Thoric16/bakalarka/Architecture_test_measurement/IMG_20260623_165900.jpg

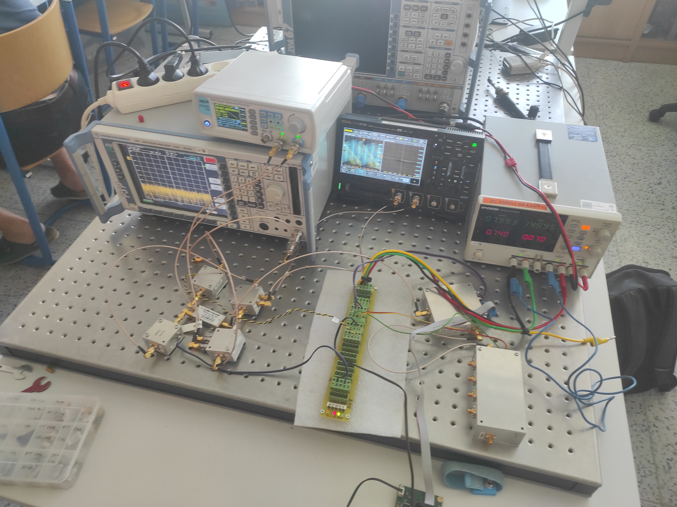
Architecture_test_measurement/IMG_20260623_165900.jpg
