Thoric16/bakalarka/Datasheets/image.png

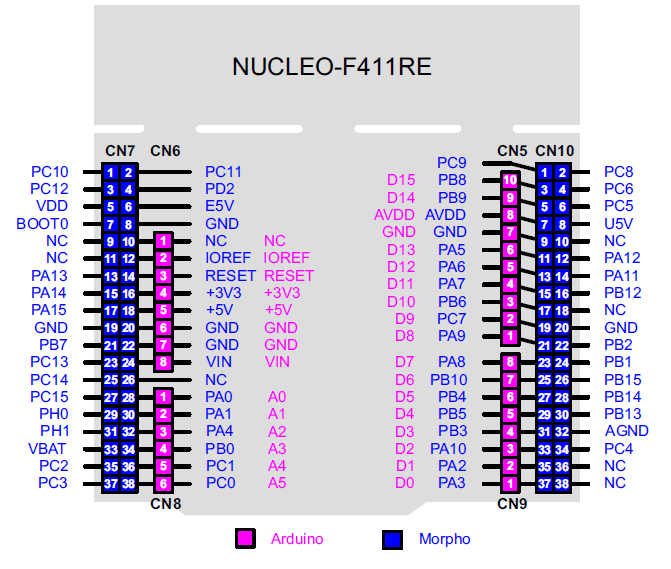
Datasheets/image.png
