Thoric16/bakalarka/preliminary block diagram/diagram_rev1.png

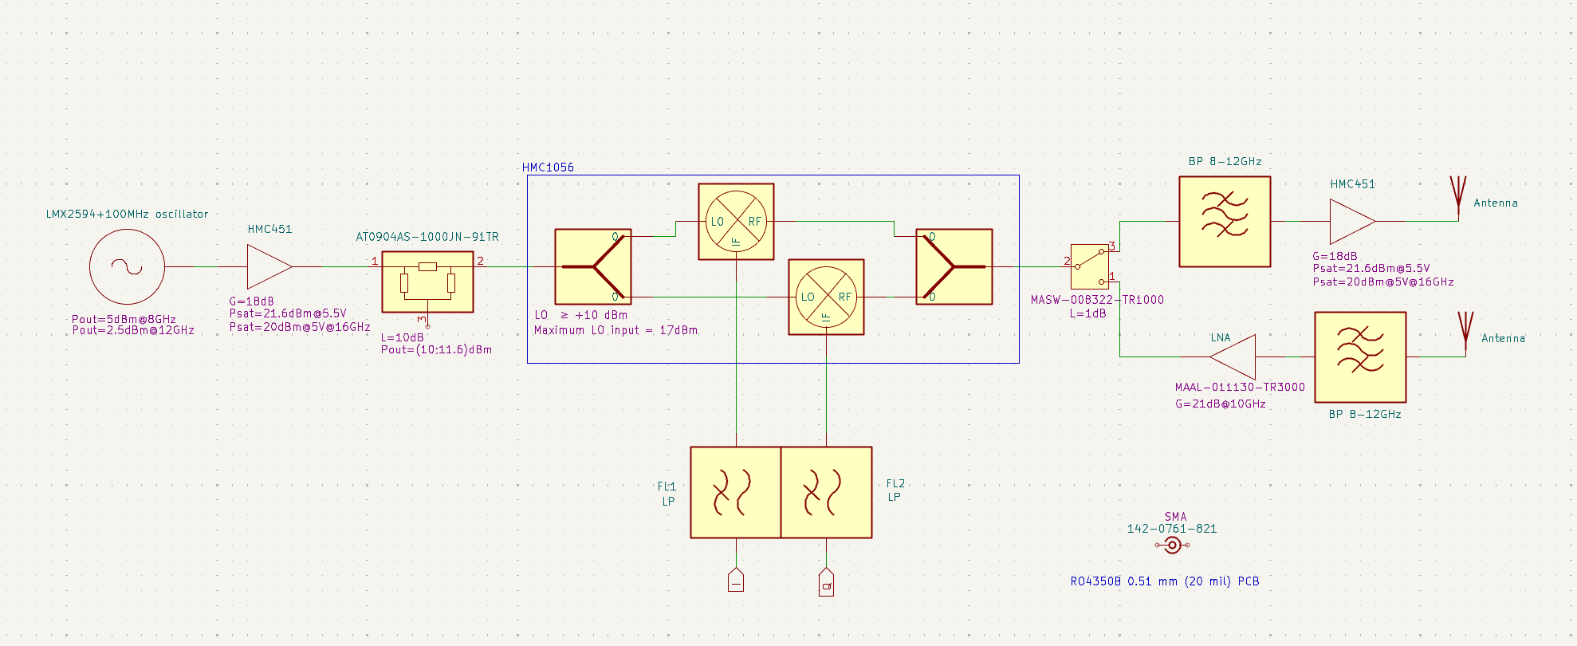
preliminary block diagram/diagram_rev1.png
