Thoric16/bakalarka/STM_QAM_GENERATOR/SHIELD_FW/Communication_protocol/image.png

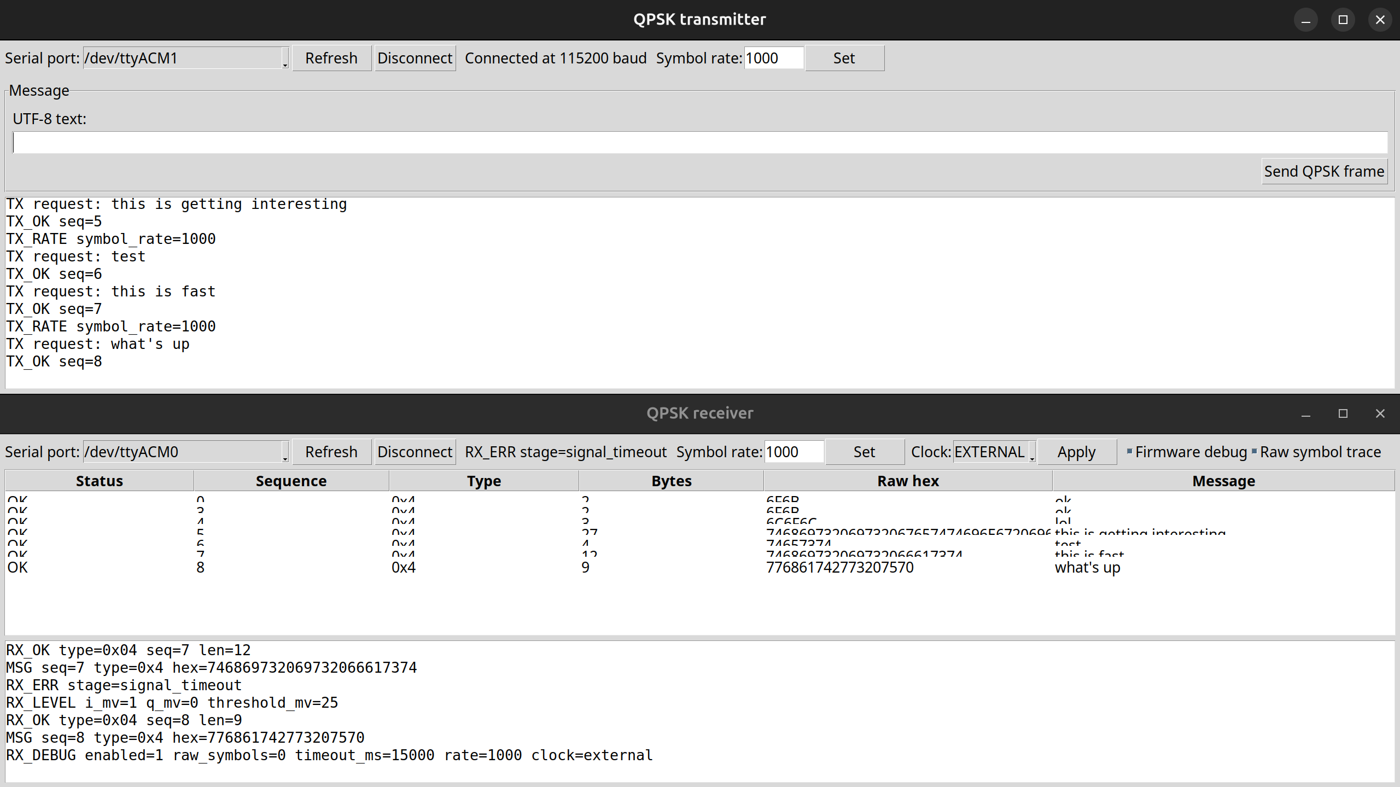
STM_QAM_GENERATOR/SHIELD_FW/Communication_protocol/image.png
