Thoric16/bakalarka/STM_QAM_GENERATOR/STM_SHIELD/image.png

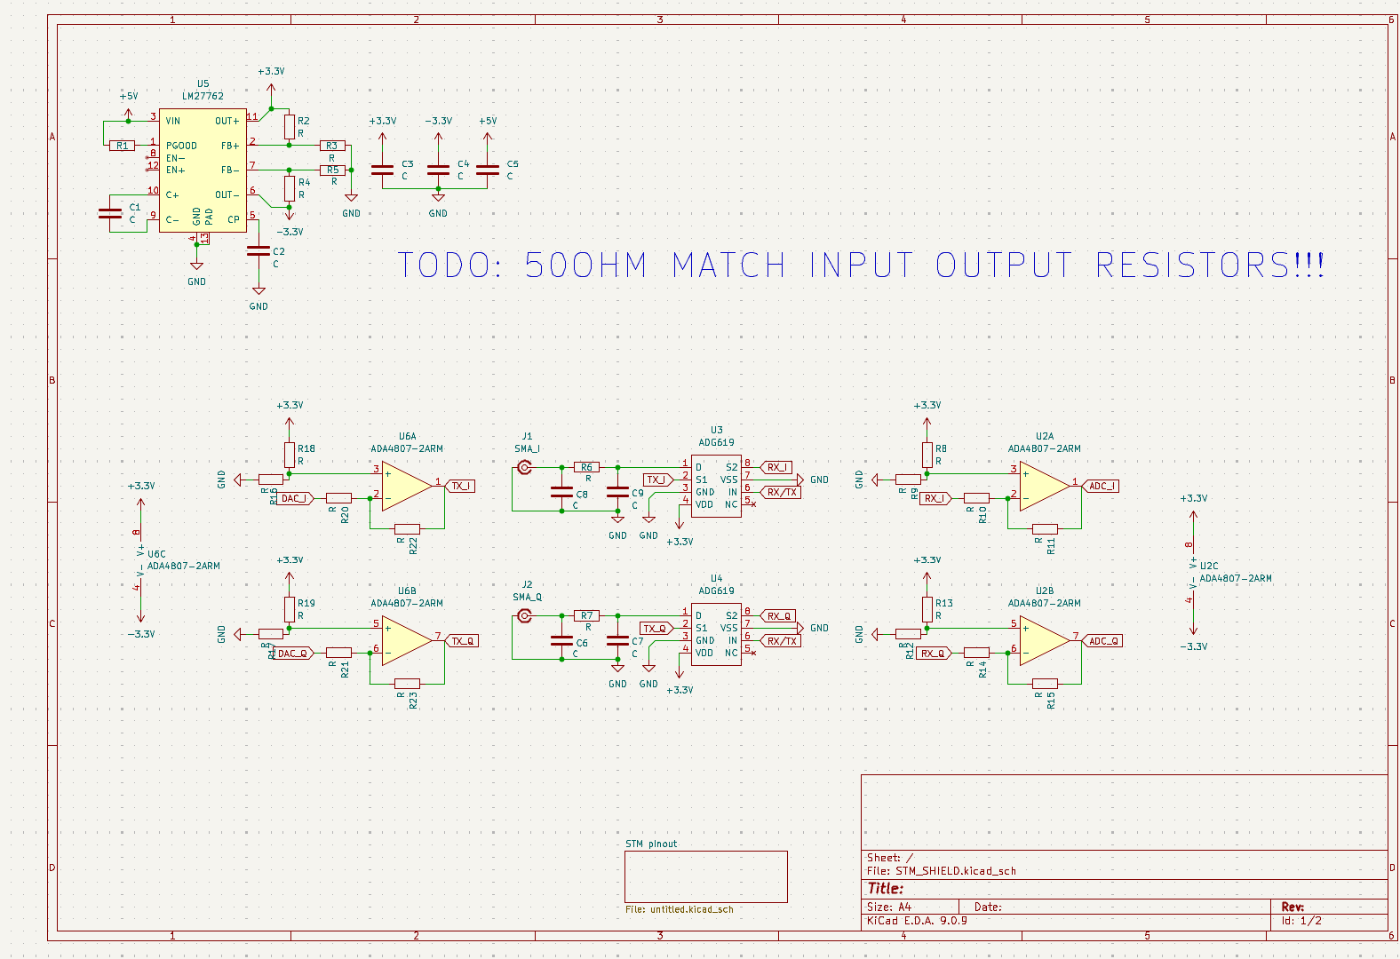
STM_QAM_GENERATOR/STM_SHIELD/image.png
