Thoric16/bakalarka/RF_board_REV1/BOM.txt

https://docs.google.com/spreadsheets/d/1QGv1TpnheeDd2i1CuFi3MqSWFdxPBb4x9R7uW8GkH_U/edit?usp=sharing
