Thoric16/bakalarka/Architecture_test_measurement/image.png

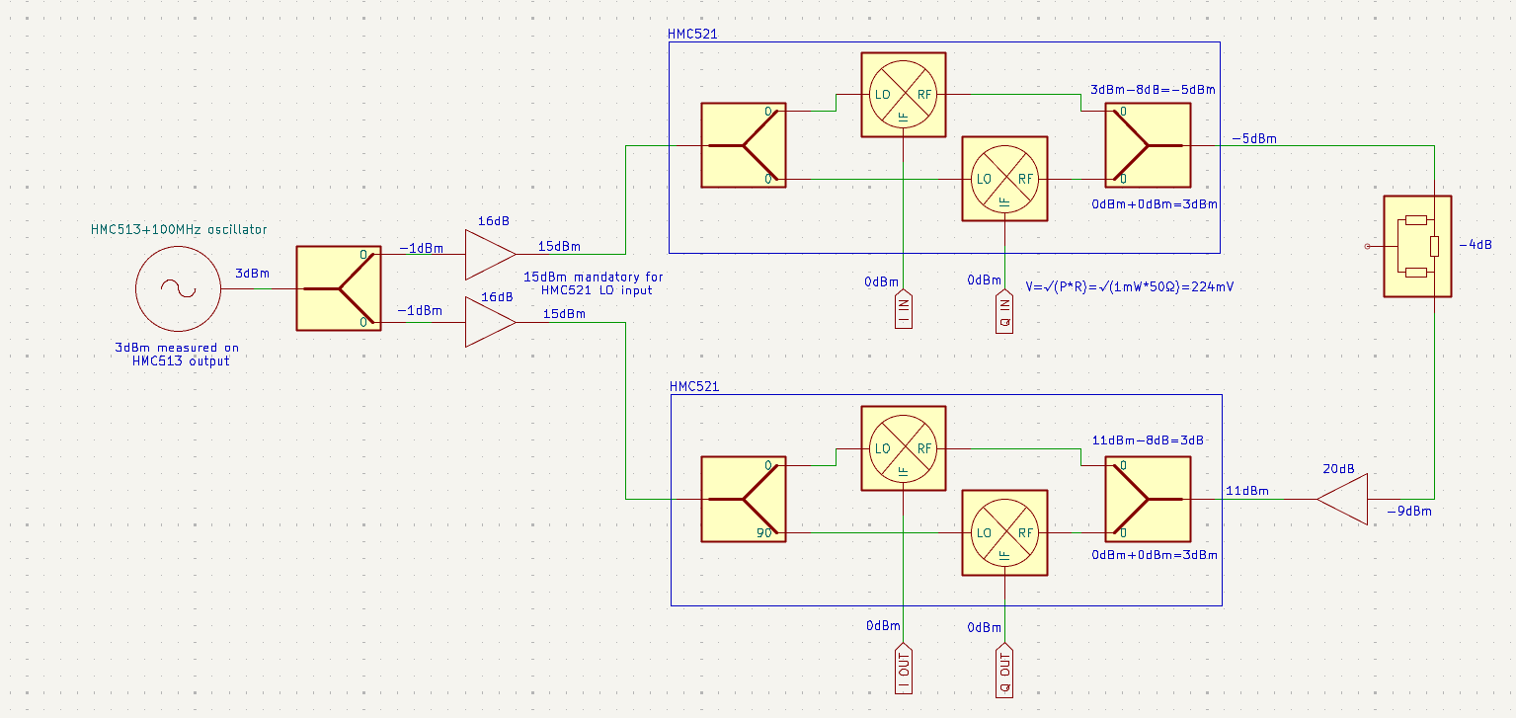
Architecture_test_measurement/image.png
