Thoric16/bakalarka/Architecture_test_measurement/IMG_20260623_165903.jpg

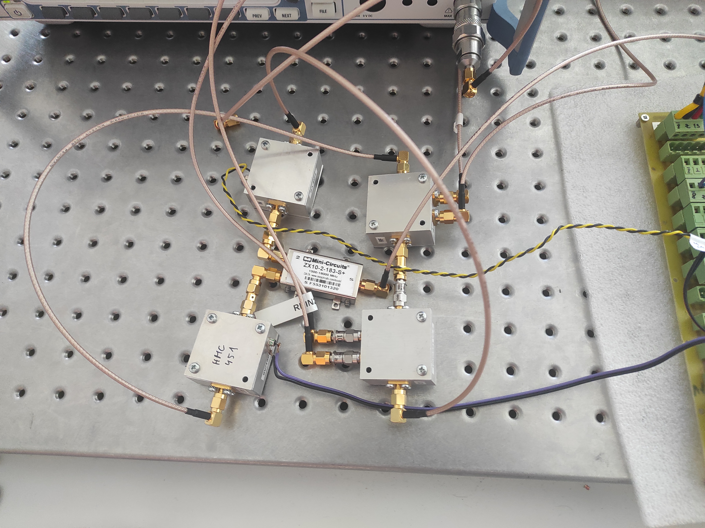
Architecture_test_measurement/IMG_20260623_165903.jpg
