Thoric16/bakalarka/Architecture_test_measurement/IMG_20260623_165911.jpg

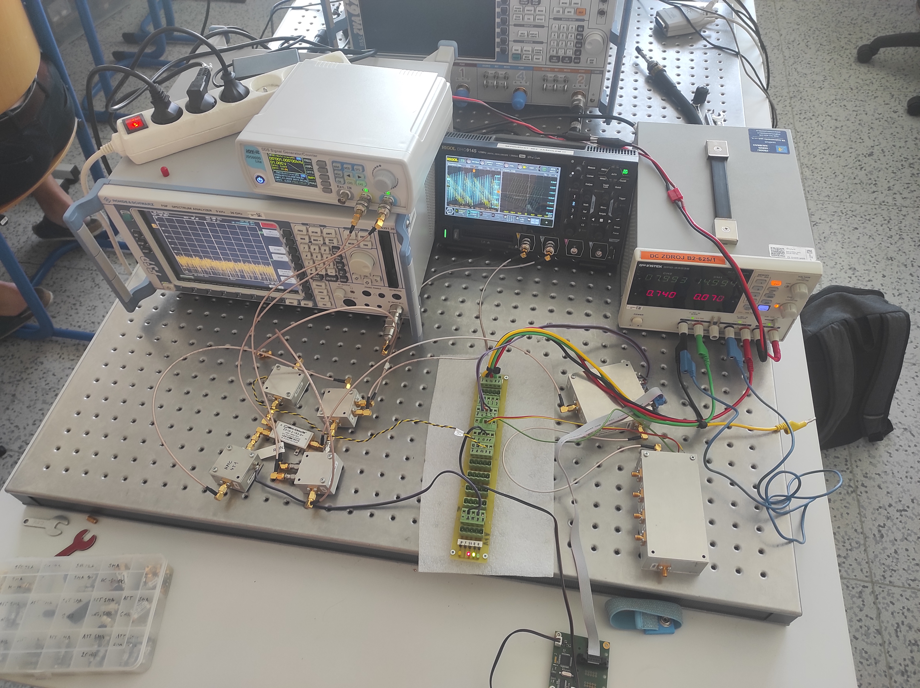
Architecture_test_measurement/IMG_20260623_165911.jpg
