Thoric16/bakalarka/STM_QAM_GENERATOR/STM_SHIELD/STM_SHIELD.kicad_pcb

## KiCad design STM_QAM_GENERATOR/STM_SHIELD/STM_SHIELD.kicad_pcb (2026-10-19)

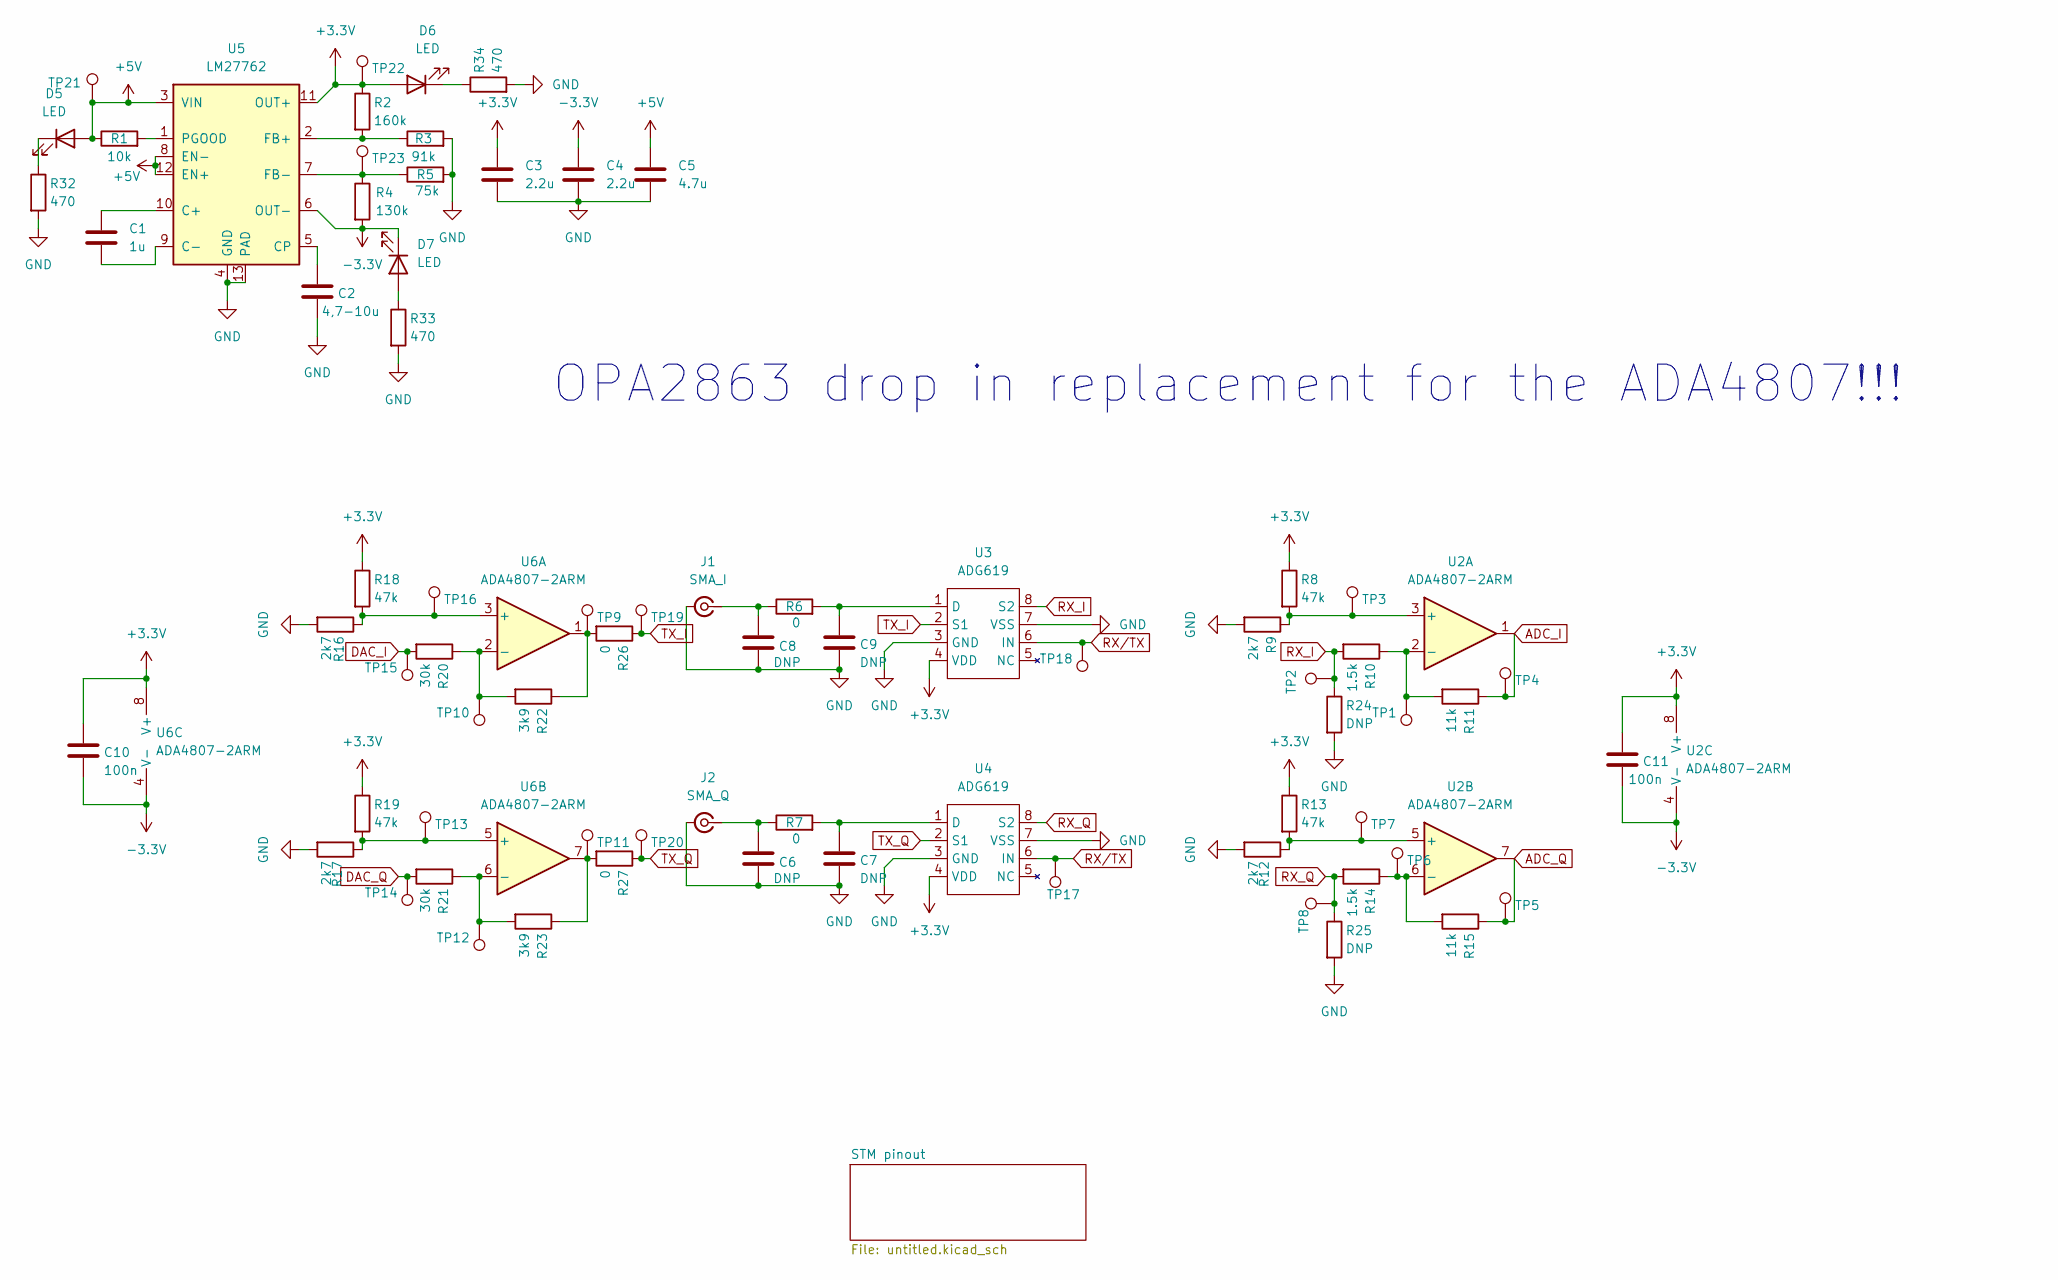
[picture p40: schematic STM_SHIELD.kicad_sch]

Parts:
C1: 1u; C_0603_1608Metric_Pad1.08x0.95mm_HandSolder
C2: 4,7-10u; C_0603_1608Metric_Pad1.08x0.95mm_HandSolder
C3, C4: 2.2u; C_0603_1608Metric_Pad1.08x0.95mm_HandSolder
C5: 4.7u; C_0603_1608Metric_Pad1.08x0.95mm_HandSolder
C6, C7, C8, C9: DNP; C_0603_1608Metric_Pad1.08x0.95mm_HandSolder
C10, C11: 100n; C_0603_1608Metric_Pad1.08x0.95mm_HandSolder
D5, D6, D7: LED; LED_0603_1608Metric_Pad1.05x0.95mm_HandSolder
J1: SMA_I; SMA_Samtec_SMA-J-P-H-ST-EM1_EdgeMount
J2: SMA_Q; SMA_Samtec_SMA-J-P-H-ST-EM1_EdgeMount
R1: 10k; R_0603_1608Metric_Pad0.98x0.95mm_HandSolder
R2: 160k; R_0603_1608Metric_Pad0.98x0.95mm_HandSolder
R3: 91k; R_0603_1608Metric_Pad0.98x0.95mm_HandSolder
R4: 130k; R_0603_1608Metric_Pad0.98x0.95mm_HandSolder
R5: 75k; R_0603_1608Metric_Pad0.98x0.95mm_HandSolder
R6, R7, R26, R27: 0; R_0603_1608Metric_Pad0.98x0.95mm_HandSolder
R8, R13, R18, R19: 47k; R_0603_1608Metric_Pad0.98x0.95mm_HandSolder
R9, R12, R16, R17: 2k7; R_0603_1608Metric_Pad0.98x0.95mm_HandSolder
R10, R14: 1.5k; R_0603_1608Metric_Pad0.98x0.95mm_HandSolder
R11, R15: 11k; R_0603_1608Metric_Pad0.98x0.95mm_HandSolder
R20, R21: 30k; R_0603_1608Metric_Pad0.98x0.95mm_HandSolder
R22, R23: 3k9; R_0603_1608Metric_Pad0.98x0.95mm_HandSolder
R24, R25: DNP; R_0603_1608Metric_Pad0.98x0.95mm_HandSolder
R32, R33, R34: 470; R_0603_1608Metric_Pad0.98x0.95mm_HandSolder
TP1, TP2, TP3, TP4, TP5, TP6, TP7, TP8, TP9, TP10, TP11, TP12, TP13, TP14, TP15, TP16, TP17, TP18, TP19, TP20, TP21, TP22, TP23: TestPoint; TestPoint_Pad_D1.0mm
U2, U6: ADA4807-2ARM; MSOP-8_3x3mm_P0.65mm
U3, U4: ADG619; MSOP-8_3x3mm_P0.65mm
U5: LM27762; WSON-12-1EP_3x2mm_P0.5mm_EP1x2.65_ThermalVias

Connections:
+3.3V: C3.2, C10.2, C11.2, D6.2 (A), R2.1, R8.1, R13.1, R18.1, R19.1, TP22.1, U2.8 (V+), U3.4 (VDD), U4.4 (VDD), U5.11 (OUT+), U6.8 (V+)
+5V: C5.2, D5.2 (A), R1.1, TP21.1, U5.3 (VIN), U5.8 (EN-), U5.12 (EN+); also elsewhere on the board
-3.3V: C4.2, C10.1, C11.1, D7.1 (K), R4.2, U2.4 (V-), U5.6 (OUT-), U6.4 (V-)
ADC_I: R11.1, TP4.1, U2.1; also elsewhere on the board
ADC_Q: R15.1, TP5.1, U2.7; also elsewhere on the board
DAC_I: R20.2, TP15.1; also elsewhere on the board
DAC_Q: R21.2, TP14.1; also elsewhere on the board
GND: C2.1, C3.1, C4.1, C5.1, C6.1, C7.1, C8.1, C9.1, J1.2 (Ext), J2.2 (Ext), R3.2, R5.2, R9.2, R12.2, R16.2, R17.2, R24.2, R25.2, R32.2, R33.2, R34.2, U3.3 (GND), U3.7 (VSS), U4.3 (GND), U4.7 (VSS), U5.4 (GND), U5.13 (PAD); also elsewhere on the board
unnamed: D5.1 (K), R32.1
unnamed: D6.1 (K), R34.1
unnamed: D7.2 (A), R33.1
unnamed: C8.2, J1.1 (In), R6.1
unnamed: C6.2, J2.1 (In), R7.1
unnamed: R22.1, R26.2, TP9.1, U6.1
unnamed: R23.1, R27.2, TP11.1, U6.7
unnamed: R8.2, R9.1, TP3.1, U2.3 (+)
unnamed: R10.1, R11.2, TP1.1, U2.2 (-)
unnamed: R12.1, R13.2, TP7.1, U2.5 (+)
unnamed: R14.1, R15.2, TP6.1, U2.6 (-)
unnamed: C9.2, R6.2, U3.1 (D)
unnamed: C7.2, R7.2, U4.1 (D)
unnamed: C1.2, U5.10 (C+)
unnamed: C1.1, U5.9 (C-)
unnamed: C2.2, U5.5 (CP)
unnamed: R2.2, R3.1, U5.2 (FB+)
unnamed: R4.1, R5.1, TP23.1, U5.7 (FB-)
unnamed: R1.2, U5.1 (PGOOD)
unnamed: R16.1, R18.2, TP16.1, U6.3 (+)
unnamed: R20.1, R22.2, TP10.1, U6.2 (-)
unnamed: R17.1, R19.2, TP13.1, U6.5 (+)
unnamed: R21.1, R23.2, TP12.1, U6.6 (-)
RX_I: R10.2, R24.1, TP2.1, U3.8 (S2)
RX_Q: R14.2, R25.1, TP8.1, U4.8 (S2)
RX/TX: TP17.1, TP18.1, U3.6 (IN), U4.6 (IN); also elsewhere on the board
TX_I: R26.1, TP19.1, U3.2 (S1)
TX_Q: R27.1, TP20.1, U4.2 (S1)

Notes on the sheet:
OPA2863 drop in replacement for the ADA4807!!!

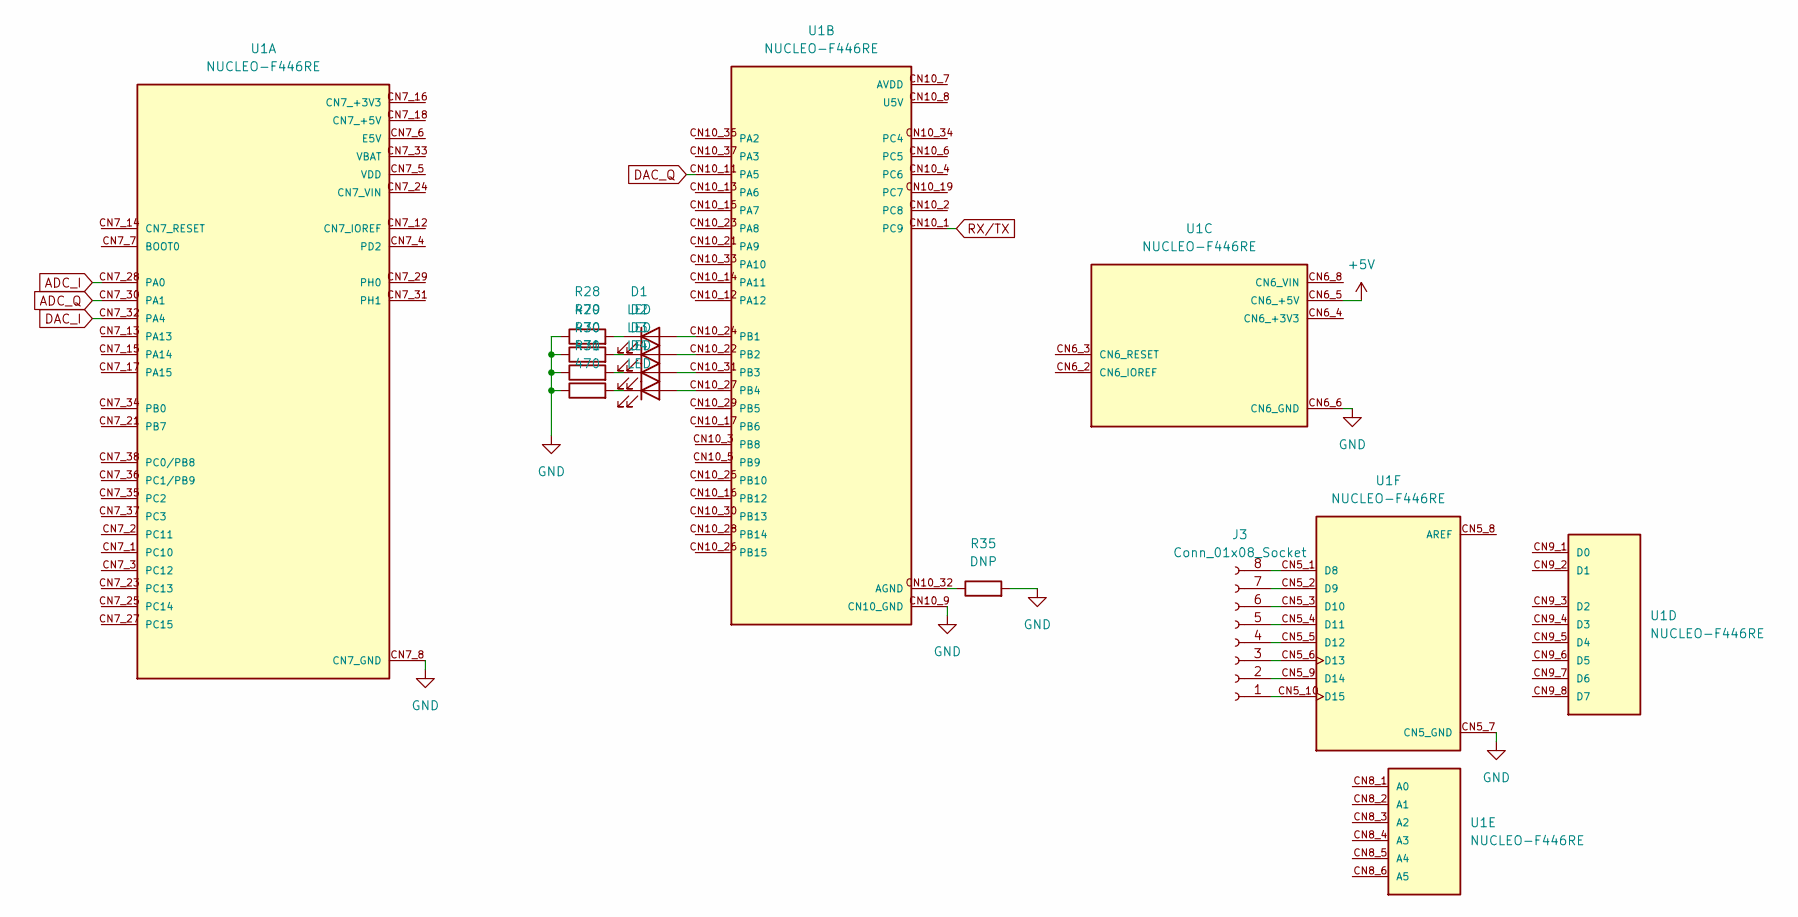
[picture p41: schematic untitled.kicad_sch]

Parts:
D1, D2, D3, D4: LED; LED_0603_1608Metric_Pad1.05x0.95mm_HandSolder
J3: Conn_01x08_Socket; PinSocket_1x08_P2.54mm_Vertical
R28, R29, R30, R31: 470; R_0603_1608Metric_Pad0.98x0.95mm_HandSolder
R35: DNP; R_0603_1608Metric_Pad0.98x0.95mm_HandSolder
U1: NUCLEO-F446RE; MODULE_NUCLEO-F446RE; PARTREV 13

Connections:
+5V: U1.CN6_5 (CN6_+5V); also elsewhere on the board
ADC_I: U1.CN7_28 (PA0); also elsewhere on the board
ADC_Q: U1.CN7_30 (PA1); also elsewhere on the board
DAC_I: U1.CN7_32 (PA4); also elsewhere on the board
DAC_Q: U1.CN10_11 (PA5); also elsewhere on the board
GND: R28.1, R29.1, R30.1, R31.1, R35.2, U1.CN5_7 (CN5_GND), U1.CN6_6 (CN6_GND), U1.CN6_7 (CN6_GND), U1.CN7_8 (CN7_GND), U1.CN7_19 (CN7_GND), U1.CN7_20 (CN7_GND), U1.CN7_22 (CN7_GND), U1.CN10_9 (CN10_GND), U1.CN10_20 (CN10_GND); also elsewhere on the board
unnamed: D1.2 (A), U1.CN10_24 (PB1)
unnamed: D1.1 (K), R28.2
unnamed: D2.2 (A), U1.CN10_22 (PB2)
unnamed: D2.1 (K), R29.2
unnamed: D3.2 (A), U1.CN10_31 (PB3)
unnamed: D3.1 (K), R30.2
unnamed: D4.2 (A), U1.CN10_27 (PB4)
unnamed: D4.1 (K), R31.2
unnamed: J3.1, U1.CN5_10 (D15)
unnamed: J3.2, U1.CN5_9 (D14)
unnamed: J3.3, U1.CN5_6 (D13)
unnamed: J3.4, U1.CN5_5 (D12)
unnamed: J3.5, U1.CN5_4 (D11)
unnamed: J3.6, U1.CN5_3 (D10)
unnamed: J3.7, U1.CN5_2 (D9)
unnamed: J3.8, U1.CN5_1 (D8)
unnamed: R35.1, U1.CN10_32 (AGND)
RX/TX: U1.CN10_1 (PC9); also elsewhere on the board

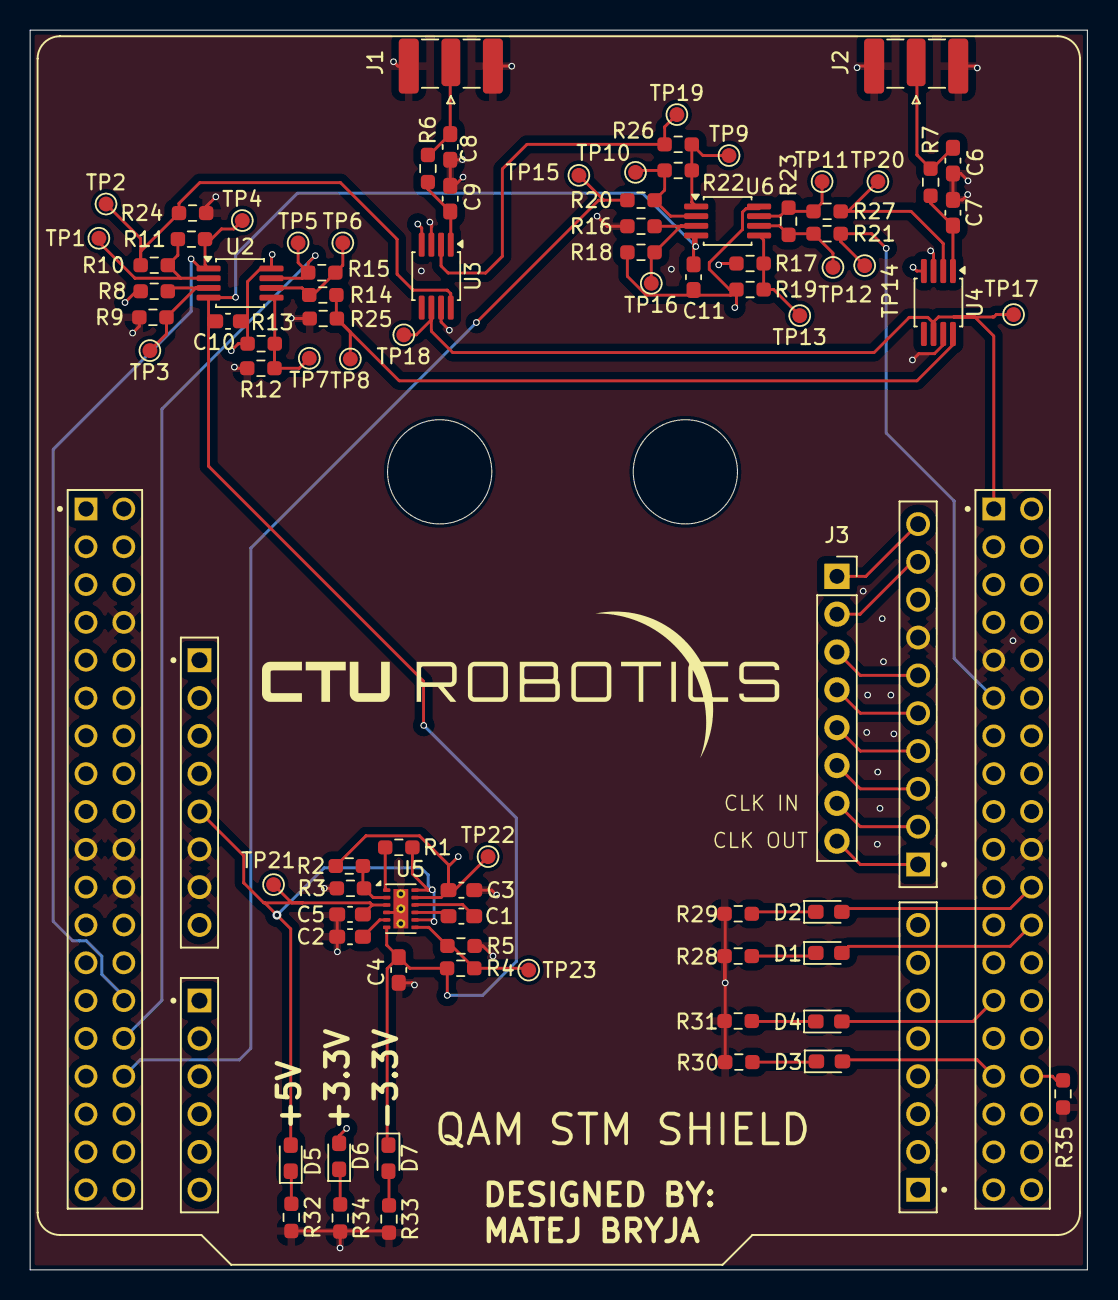
[picture p42: board STM_SHIELD.kicad_pcb from above]

Board: 4 copper layers, 71.0 x 83.2 mm, 85 parts (0 on the bottom side), 53 nets.
