Thoric16/bakalarka/(commit log)

2026-06-06 nucleo-f446re -STM32F446RE Datasheet added
2026-06-06 preliminary schematic added
2026-06-07 Preliminary diagram KiCad
    [preliminary block diagram.kicad_pcb, preliminary block diagram.kicad_sch]
2026-06-30 new file: Datasheets/hmc451lp3.pdf
    [preliminary schematics.kicad_sch, rev1_block_diagram.kicad_sch]
2026-08-09 udated diagram
    [rev1_block_diagram.kicad_sch]
2026-08-16 Added selected components to the block diagram
    [rev1_block_diagram.kicad_sch]
2026-08-16 added first BOM
2026-09-15 STM shield schematic and PCB files added to the repository.
    [STM_SHIELD.kicad_pcb, STM_SHIELD.kicad_sch, untitled.kicad_sch]
2026-10-19 Added values to schematics
2026-10-25 STM ADC/DAC test scripts calibrated
