Thoric16/bakalarka/Sketches/preliminary schematic.jpg

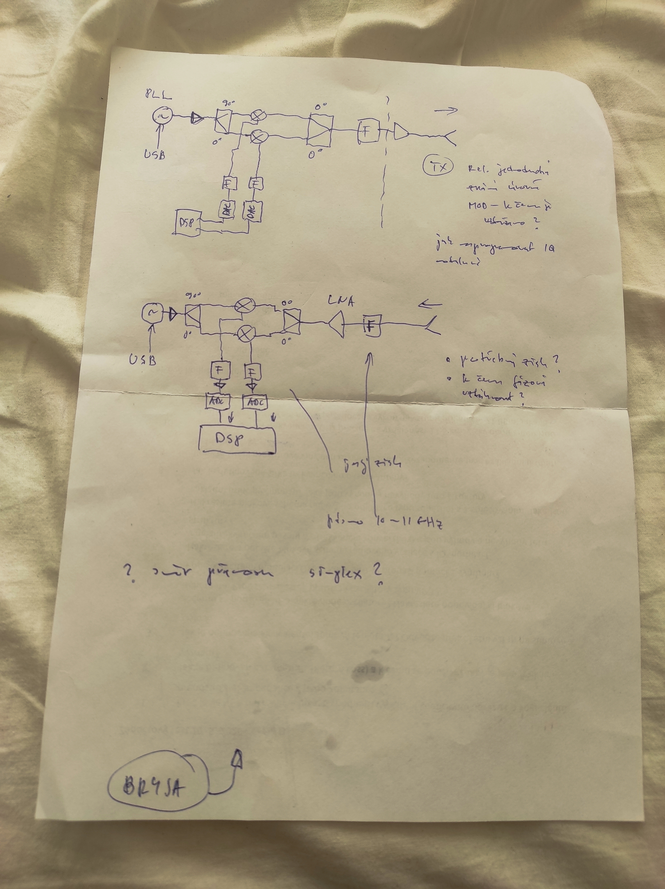
Sketches/preliminary schematic.jpg
