Thoric16/bakalarka/Sketches/QAM_sketch.jpg

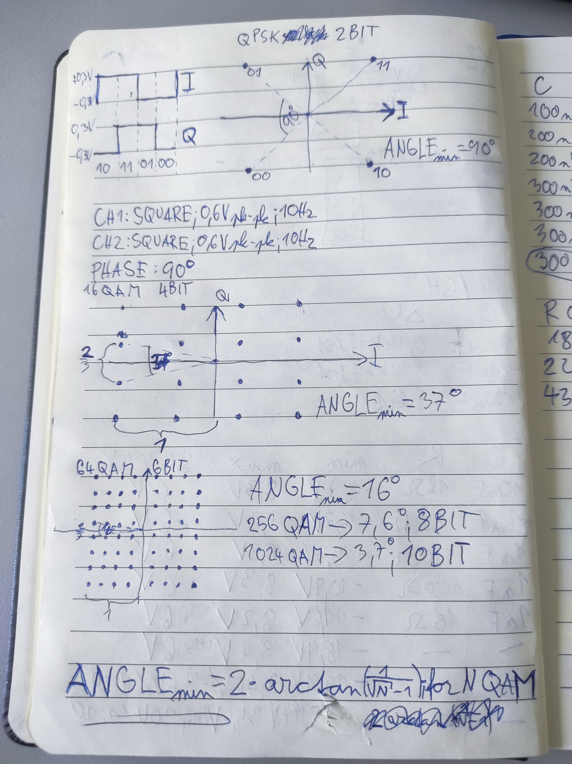
Sketches/QAM_sketch.jpg
